prodrigues0201/Home-Automation-System/Datasheets/Links_DHT11.txt

https://components101.com/sensors/dht11-temperature-sensor

https://www.elprocus.com/a-brief-on-dht11-sensor/
