prodrigues0201/Home-Automation-System/Electric_schemes/DHT11_ESP32_Connection.txt

https://randomnerdtutorials.com/esp32-dht11-dht22-temperature-humidity-sensor-arduino-ide/
