prodrigues0201/Home-Automation-System/Electric_schemes/Pzem_ESP32_Connection.txt

https://github.com/dasetiawan/ESP32-PZEM004T/wiki/ESP32-PZEM004T-Wiki!
https://fgcoca.github.io/Autocaravana-inteligente/datasheet/uart-a-hardware-communication-protocol.pdf
