prodrigues0201/Home-Automation-System/Electric_schemes/Relay_ESP32_Connection.txt

https://randomnerdtutorials.com/esp32-relay-module-ac-web-server/
