prodrigues0201/Home-Automation-System/Datasheets/Links_ESP32-C3.txt

https://forum.arduino.cc/t/esp32-c3-supermini-pinout/1189850
