prodrigues0201/Home-Automation-System/Datasheets/Links_ESP32-S2.txt

https://mischianti.org/esp32-s2-pinout-specs-and-arduino-ide-configuration-1/
