prodrigues0201/Home-Automation-System/Datasheets/Links_LDR.txt

https://www.instructables.com/How-to-Use-a-Light-Dependent-Resistor-LDR/
