prodrigues0201/Home-Automation-System/Electric_schemes/Electric_Scheme_ESP32_C3.png

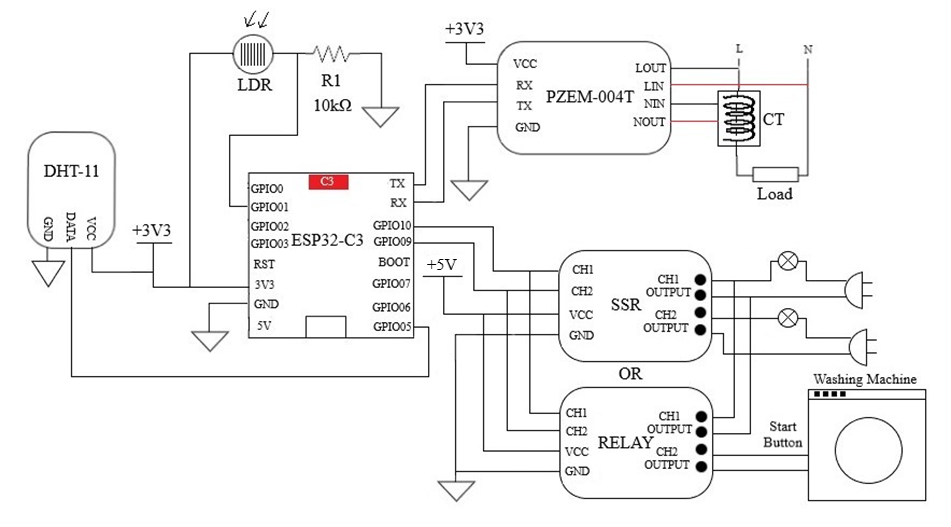
Electric_schemes/Electric_Scheme_ESP32_C3.png
