prodrigues0201/Home-Automation-System/Datasheets/Links_Home_Assistant_ConfigurationYAML.txt

https://www.home-assistant.io/examples/
https://community.home-assistant.io/tag/lights
https://opensource.com/article/21/2/home-assistant-custom-sensors
https://www.home-assistant.io/integrations/sensor.mqtt/
